chiii321/Aircon/docs/ir-captures/aux-dc-inverter-on-2026-09-18.md

# AUX DC Inverter — ON

| Field | Value |
| --- | --- |
| AC brand/model | AUX DC inverter; exact model not recorded |
| Command | ON |
| Power state | ON |
| Temperature | Not recorded during capture |
| Mode | Not recorded during capture |
| Fan setting | Not recorded during capture |
| Swing setting | Not recorded during capture |
| Decoded protocol | ELECTRA_AC |
| Date captured | 2026-09-18 |
| Replay verified | No — pending physical test |

## State data

User confirmation (2026-09-19): the ON label comes from actual AUX behavior observed during capture. Preserve these exact bytes and this label; do not reverse based on an inferred protocol bit. Replay with the temporary harvested-LED transistor circuit remains pending.

```cpp
uint8_t AUX_ON_STATE[13] = {
  0xC3, 0x88, 0xE0, 0x00, 0x40, 0x00, 0x20,
  0x00, 0x00, 0x00, 0x00, 0x05, 0x90
};
```
