chiii321/Aircon/firmware/stage1_hardware_test/device_credentials.example.h

#pragma once
// Copy to device_credentials.h and fill locally. Never commit that file.
#define WIFI_SSID "YOUR_WIFI_NAME"
#define WIFI_PASSWORD "YOUR_WIFI_PASSWORD"
#define DEVICE_TOKEN "REPLACE_WITH_A_UNIQUE_64_CHARACTER_HEX_TOKEN"
