chiii321/Aircon/firmware/stage1_hardware_test/supabase_root_ca.h

/* Google Trust Services Root R4 from https://pki.goog/repo/certs/gtsr4.pem */
static const char kSupabaseRootCa[] = R"PEM(
-----BEGIN CERTIFICATE-----
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
-----END CERTIFICATE-----
)PEM";
