chiii321/Aircon/(commit log)

2026-09-18 feat: add AUX control buttons
2026-09-18 fix: harden Stage 1 input handling and clarify hardware verification
    [stage1_hardware_test.ino]
2026-09-18 feat: add local ESP32 web controller
2026-09-18 fix: correct AUX power routing and add raw IR diagnostics
    [stage1_hardware_test.ino]
2026-09-19 fix: preserve physical AUX captures and document temporary IR driver
    [stage1_hardware_test.ino]
2026-09-20 Send confirmed COOLIX remote commands for Stage 1
2026-09-23 Focus Stage 1 on IR LED hardware testing
2026-09-23 Correct wiring table for 940 nm IR LED
2026-09-23 Document temporary harvested IR LED wiring
2026-09-25 docs: hand off website setup and device status
2026-09-25 Build authenticated ESP32 dashboard and standalone account pages
2026-09-25 Restore site control to current IR test firmware
2026-09-26 Use attached INUVAIR logo and limit Mokoto to branding
2026-09-26 Add admin approval and assigned device access
2026-10-06 Scrub local machine details, fix stale docs, and remove dead files (#4)
    Privacy:
    - Rewrite docs/website-handoff.md as a current handoff without notes about
    a local .env, one machine's shell setup, or untracked local files.
    - Remove the stale Cloudflare Pages URL and extra Vercel alias from
    docs/live-setup.md, plus a local serial-port name from a capture record.
    - Ignore *.log and the local Supabase env helper script.
    Accuracy:
    - Docs now describe what the firmware sends (ELECTRA_AC raw frames).
    - Record the unresolved ON/OFF labeling conflict without changing IR data.
    - Fix the stale CI note, repo tree, transistor naming, test-plan notice,
    original brief banner, and where privileged w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
2026-10-06 Add INUVAIR hardware and power plan
2026-10-06 Update docs to the current hardware: two IR LEDs, no receiver
    Bring the docs in line with INUVAIR_HARDWARE_AND_POWER_PLAN.md:
    - 38-pin USB-C ESP32-WROOM-32 board instead of the 30-pin board.
    - Two IR LEDs on one 2N2222A (GPIO 25), each with its own 100 ohm
    resistor, plus the 1k base resistor and 10k base pull-down.
    - IR receiver and buttons removed; GPIO 26, 27, and 33 unused.
    - Solar and battery power through the MT3608 instead of a power bank.
    README, wiring.md, PIN_CONNECTION_LAYOUT.md, ir-troubleshooting.md, and
    live-setup.md now describe that hardware. The troubleshooting guide is
    transmitter-only, with a short note on temporarily attaching a receiver
    for new captures. The README sta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
